zselgrath/ESP32_Dash_Firmware/NGDash_Image.png

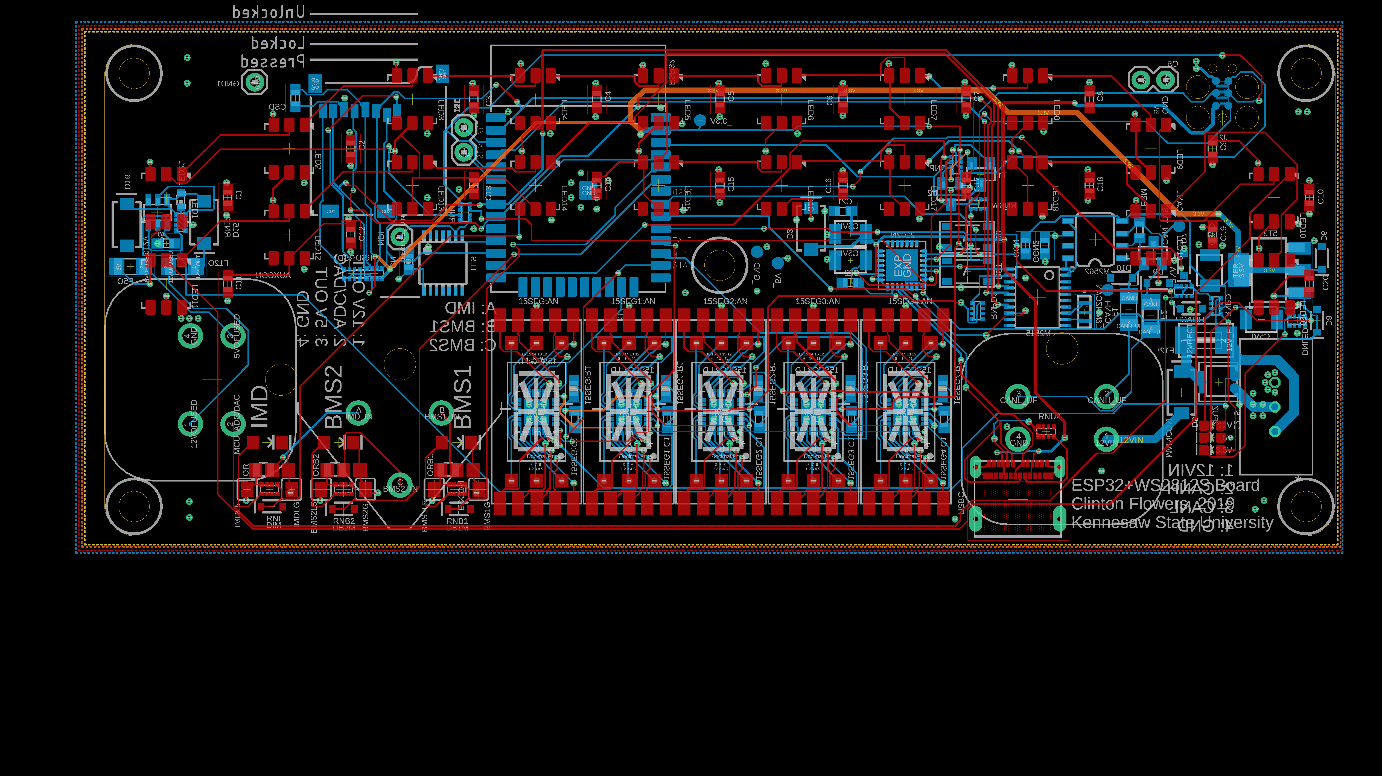
NGDash_Image.png
