zselgrath/ESP32_Dash_Firmware/NGDash.brd

## EAGLE design NGDash.brd (2019-10-20)

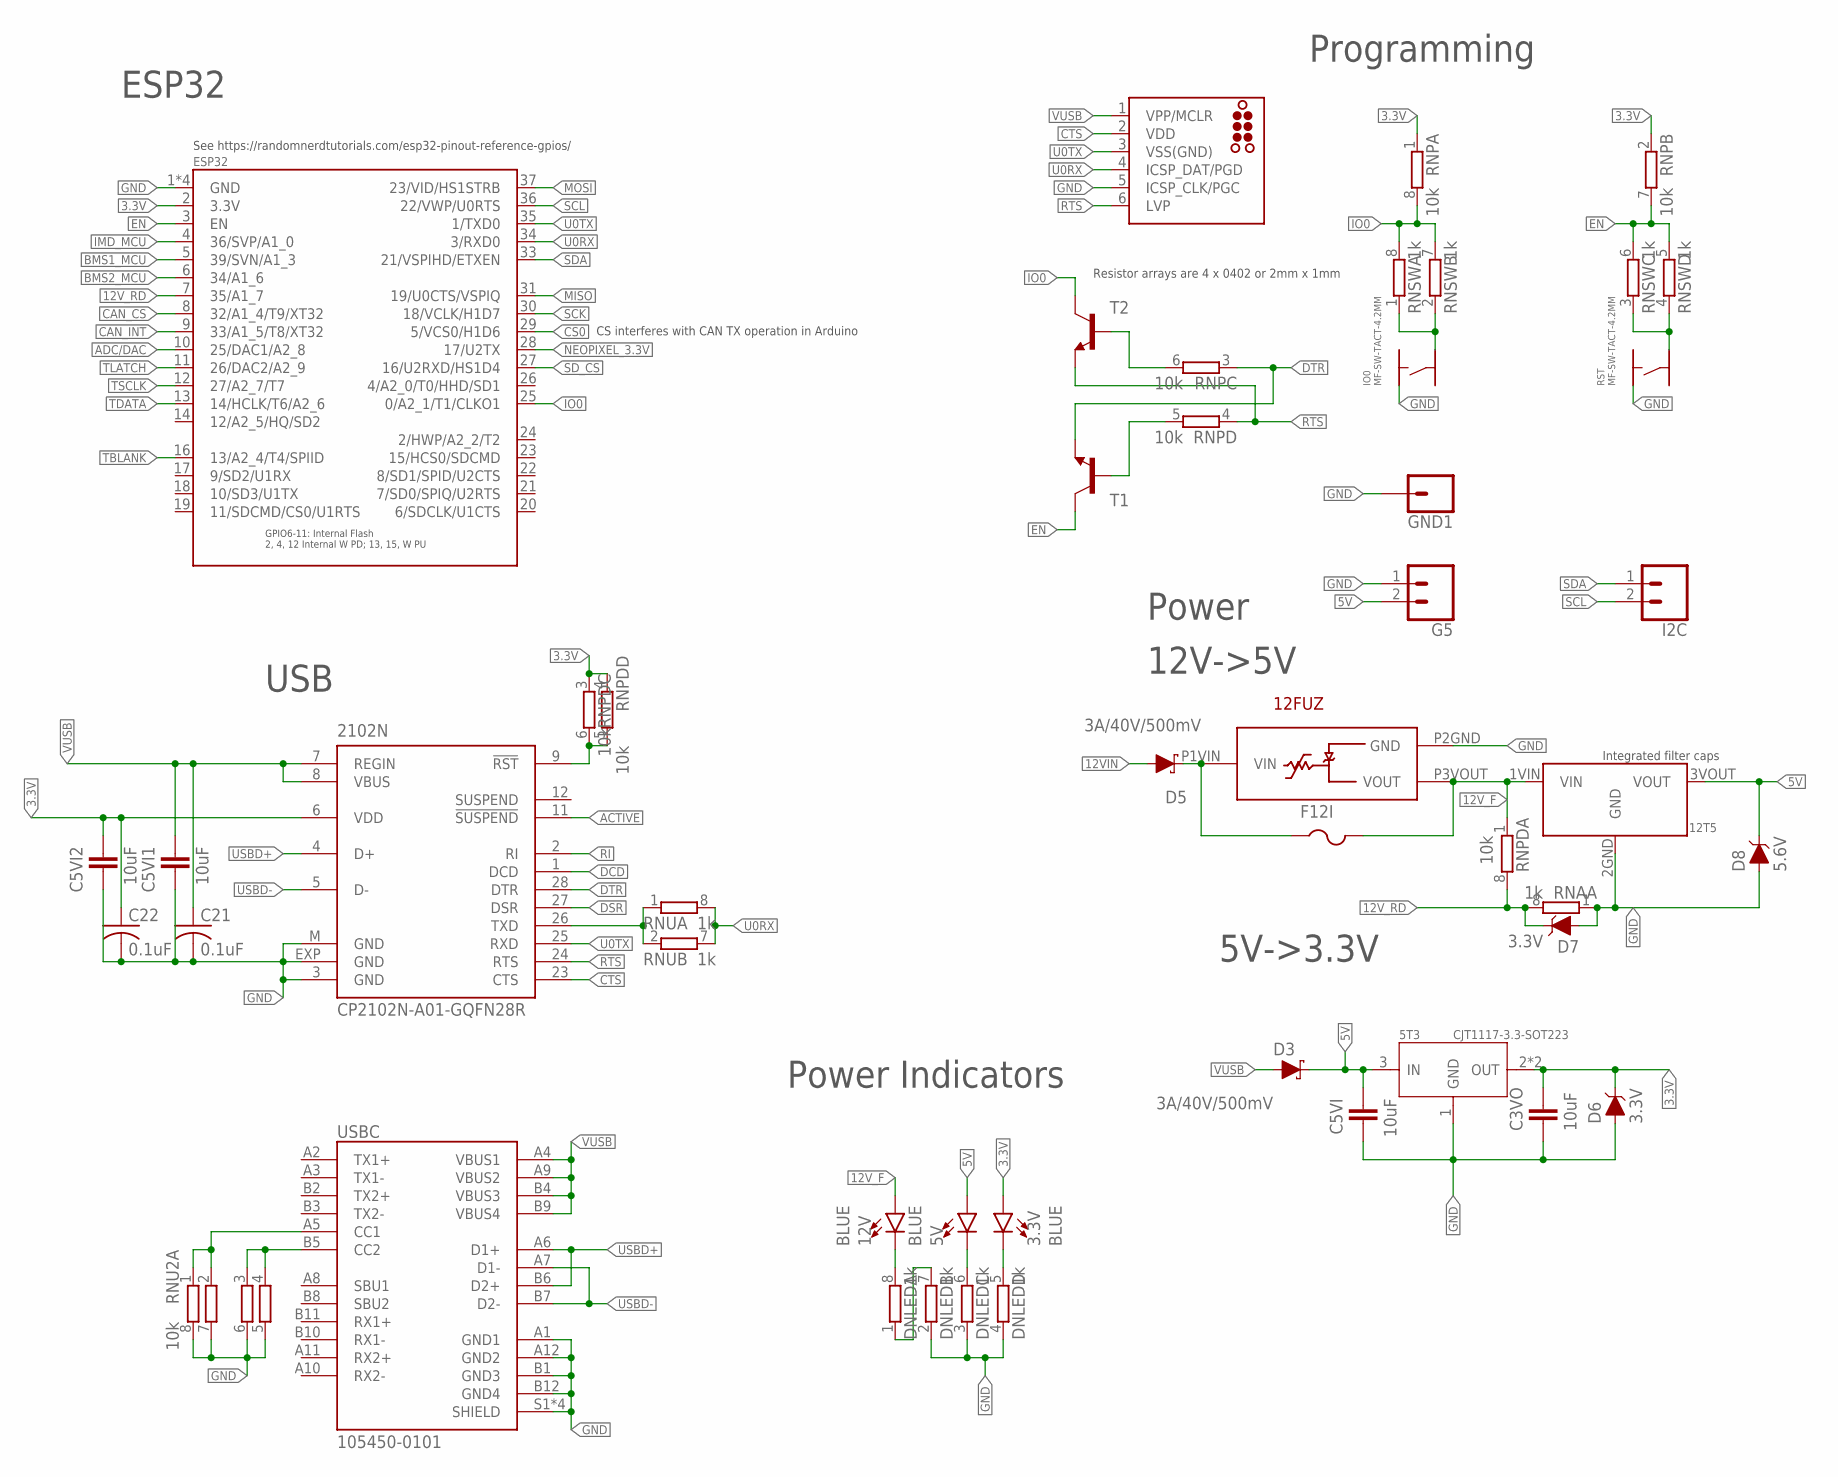
[picture p7: schematic NGDash.sch, sheet 1]

Parts:
3.3V, 5V, 12V: BLUE; LED-0603
5T3: CJT1117-3.3-SOT223; SOT-223
12FUZ: LITTELFUSE-POLYZEN-ZEN164V130A24LS
12T5: TRACO-TSR-2-2450
2102N: CP2102N-A01-GQFN28R; MLP28
C3VO, C5VI, C5VI1, C5VI2: 10uF; 1210
C21, C22: 0.1uF; C0603
D3, D5: 3A/40V/500mV; SMA-DIODE
D6, D7: 3.3V; SOD-323
D8: 5.6V; SOD-323
DNLED: 1k; 4X0402ARV341
ESP32: ESP32-WROOM-32; ESP32-WROOM32
F12I: PTCFUSE-1812; 1812
G5: CONN_02; 1X02
GND1: CONN_01; 1X01
I2C: CONN_02; 1X02
IO0: MF-SW-TACT-4.2MM; TACT4.2MM
J2: TC2030-MCP
RNA: 1k; 4X0402ARV341
RNP: 10k; 4X0402ARV341
RNPD: 10k; 4X0402ARV341
RNSW: 1k; 4X0402ARV341
RNU: 1k; 4X0402ARV341
RNU2: 10k; 4X0402ARV341
RST: MF-SW-TACT-4.2MM; TACT4.2MM
T1, T2: BC850-NPN-SOT23-BEC; SOT23-BEC
USBC: 105450-0101; MOLEX_105450-0101

Connections:
3.3V: 3.3V.A, 5T3.2 (OUT), 5T3.TER (OUT), 2102N.6 (VDD), C3VO.1, C5VI2.1, C22.1, D6.C, ESP32.2 (3.3V), RNP.1, RNP.2 (1), RNPD.3 (1), RNPD.4 (1); also elsewhere on the board
5V: 5T3.3 (IN), 5V.A, 12T5.3VOUT (VOUT), C5VI.1, D3.C, D8.C, G5.2; also elsewhere on the board
12VIN: D5.A; also elsewhere on the board
12VRECT: 12FUZ.P1VIN (VIN), D5.C, F12I.1
12V_F: 12FUZ.P3VOUT (VOUT), 12T5.1VIN (VIN), 12V.A, F12I.2, RNPD.1; also elsewhere on the board
12V_RD: D7.C, ESP32.7 (35/A1_7), RNA.8 (2), RNPD.8 (2)
ACTIVE: 2102N.11 (!SUSPEND)
ADC/DAC: ESP32.10 (25/DAC1/A2_8); also elsewhere on the board
BMS1_MCU: ESP32.5 (39/SVN/A1_3); also elsewhere on the board
BMS2_MCU: ESP32.6 (34/A1_6); also elsewhere on the board
CAN_CS: ESP32.8 (32/A1_4/T9/XT32); also elsewhere on the board
CAN_INT: ESP32.9 (33/A1_5/T8/XT32); also elsewhere on the board
CS0: ESP32.29 (5/VCS0/H1D6)
CTS: 2102N.23 (CTS), J2.2 (VDD)
DCD: 2102N.1 (DCD)
DSR: 2102N.27 (DSR)
DTR: 2102N.28 (DTR), RNP.3 (1), T1.E
EN: ESP32.3 (EN), RNP.7 (2), RNSW.5 (2), RNSW.6 (2), T1.C
GND: 5T3.1 (GND), 12FUZ.P2GND (GND), 12T5.2GND (GND), 2102N.3 (GND), 2102N.EXP (GND), 2102N.M (GND), C3VO.2, C5VI.2, C5VI1.2, C5VI2.2, C21.2, C22.2, D6.A, D7.A, D8.A, DNLED.2 (1), DNLED.3 (1), DNLED.4 (1), ESP32.1 (GND), ESP32.15 (GND), ESP32.38 (GND), ESP32.GND, G5.1, GND1.1, IO0.P$1, J2.5 (ICSP_CLK/PGC), RNA.1, RNU2.5 (2), RNU2.6 (2), RNU2.7 (2), RNU2.8 (2), RST.P$1, USBC.A1 (GND1), USBC.A12 (GND2), USBC.B1 (GND3), USBC.B12 (GND4), USBC.S1 (SHIELD), USBC.S2 (SHIELD), USBC.S3 (SHIELD), USBC.S4 (SHIELD); also elsewhere on the board
IMD_MCU: ESP32.4 (36/SVP/A1_0); also elsewhere on the board
IO0: ESP32.25 (0/A2_1/T1/CLKO1), RNP.8 (2), RNSW.7 (2), RNSW.8 (2), T2.C
MISO: ESP32.31 (19/U0CTS/VSPIQ); also elsewhere on the board
MOSI: ESP32.37 (23/VID/HS1STRB); also elsewhere on the board
unnamed: 5V.C, DNLED.6 (2)
unnamed: IO0.P$4, RNSW.1, RNSW.2 (1)
unnamed: RNP.5 (2), T1.B
unnamed: RNP.6 (2), T2.B
unnamed: RNU2.1, RNU2.2 (1), USBC.A5 (CC1)
unnamed: RNSW.3 (1), RNSW.4 (1), RST.P$4
unnamed: 3.3V.C, DNLED.5 (2)
unnamed: 2102N.9 (!RST), RNPD.5 (2), RNPD.6 (2)
unnamed: RNU2.3 (1), RNU2.4 (1), USBC.B5 (CC2)
unnamed: DNLED.1, DNLED.7 (2)
unnamed: 12V.C, DNLED.8 (2)
NEOPIXEL_3.3V: ESP32.28 (17/U2TX); also elsewhere on the board
RI: 2102N.2 (RI)
RTS: 2102N.24 (RTS), J2.6 (LVP), RNP.4 (1), T2.E
SCK: ESP32.30 (18/VCLK/H1D7); also elsewhere on the board
SCL: ESP32.36 (22/VWP/U0RTS), I2C.2
SDA: ESP32.33 (21/VSPIHD/ETXEN), I2C.1
SD_CS: ESP32.27 (16/U2RXD/HS1D4); also elsewhere on the board
TBLANK: ESP32.16 (13/A2_4/T4/SPIID); also elsewhere on the board
TDATA: ESP32.13 (14/HCLK/T6/A2_6); also elsewhere on the board
TLATCH: ESP32.11 (26/DAC2/A2_9); also elsewhere on the board
TSCLK: ESP32.12 (27/A2_7/T7); also elsewhere on the board
U0RX: ESP32.34 (3/RXD0), J2.4 (ICSP_DAT/PGD), RNU.7 (2), RNU.8 (2)
U0TX: 2102N.25 (RXD), ESP32.35 (1/TXD0), J2.3 (VSS(GND))
U0TXC: 2102N.26 (TXD), RNU.1, RNU.2 (1)
USBD+: 2102N.4 (D+), USBC.A6 (D1+), USBC.B6 (D2+)
USBD-: 2102N.5 (D-), USBC.A7 (D1-), USBC.B7 (D2-)
VUSB: 2102N.7 (REGIN), 2102N.8 (VBUS), C5VI1.1, C21.1, D3.A, J2.1 (VPP/MCLR), USBC.A4 (VBUS1), USBC.A9 (VBUS2), USBC.B4 (VBUS3), USBC.B9 (VBUS4)

Notes on the sheet:
Resistor arrays are 4 x 0402 or 2mm x 1mm
USB
Programming
Power
ESP32
5V->3.3V
CS interferes with CAN TX operation in Arduino
See https://randomnerdtutorials.com/esp32-pinout-reference-gpios/
12V->5V
Integrated filter caps
Power Indicators

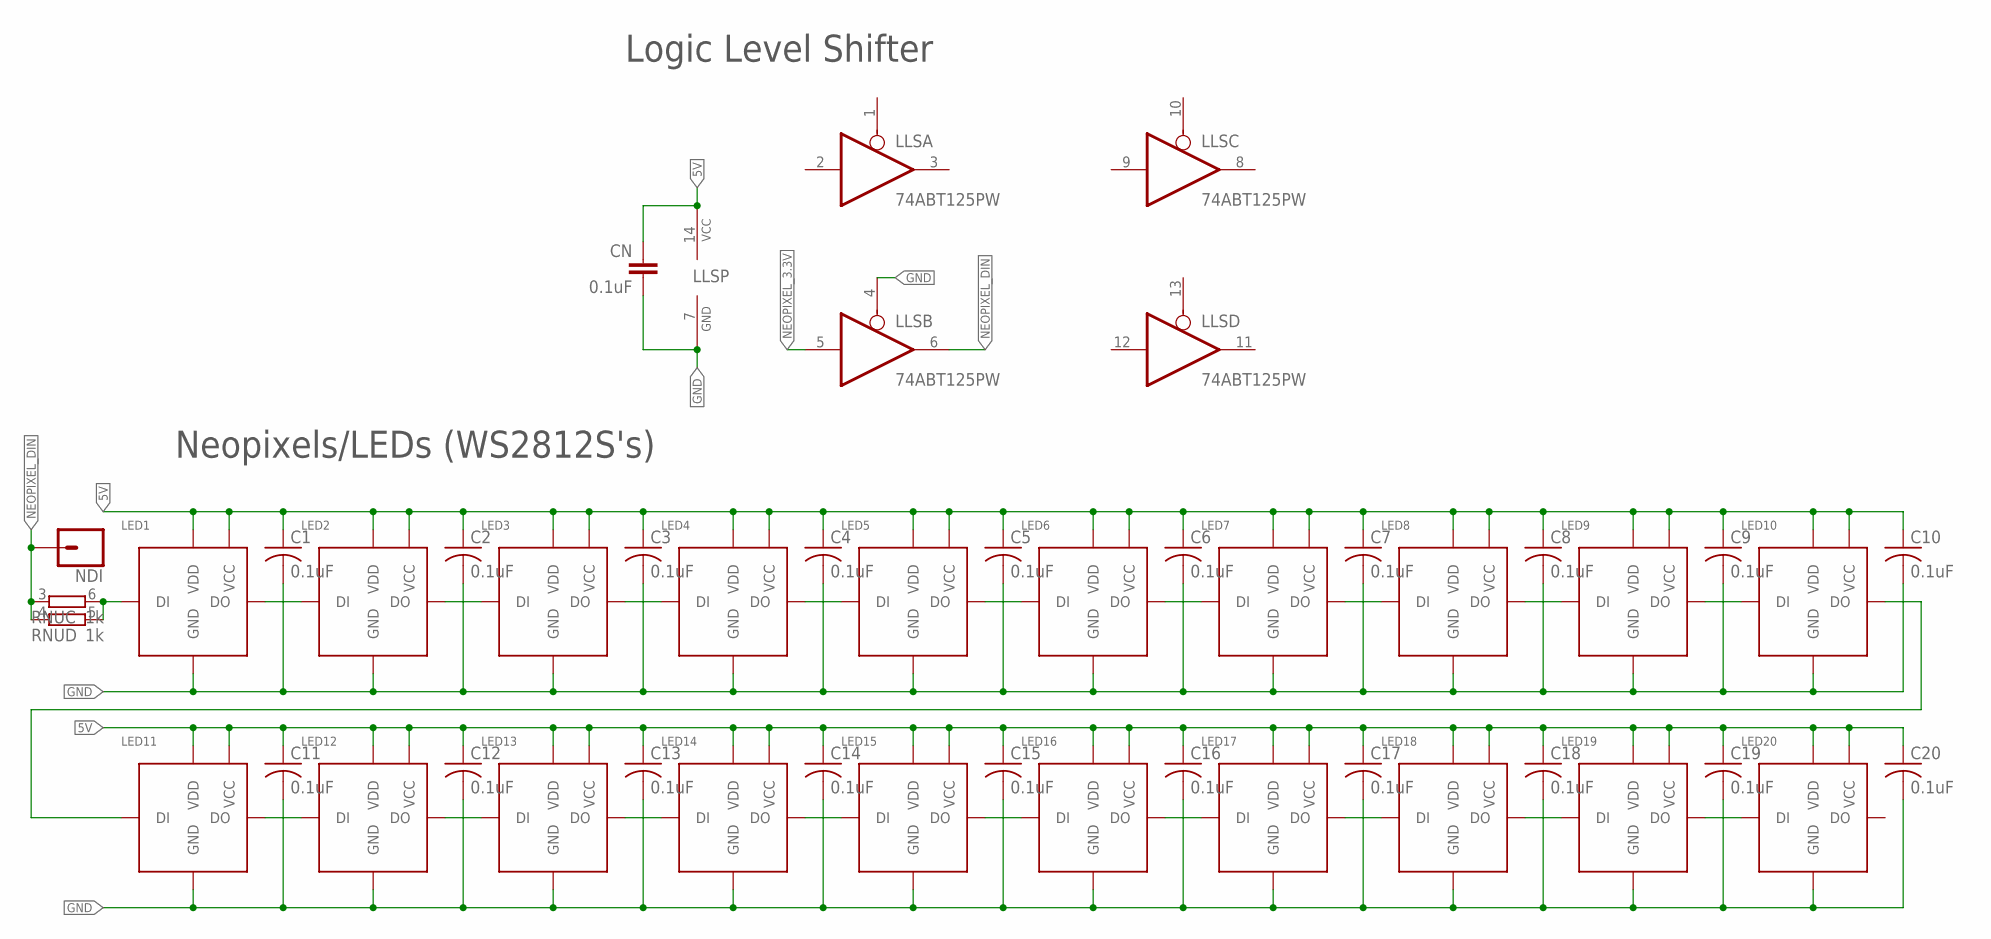
[picture p8: schematic NGDash.sch, sheet 2]

Parts:
C1, C2, C3, C4, C5, C6, C7, C8, C9, C10, C11, C12, C13, C14, C15, C16, C17, C18, C19, C20: 0.1uF; C0603
CN: 0.1uF; 0603-CAP
LED1, LED2, LED3, LED4, LED5, LED6, LED7, LED8, LED9, LED10, LED11, LED12, LED13, LED14, LED15, LED16, LED17, LED18, LED19, LED20: WS2812S; WS2812S5050
LLS: 74ABT125PW; TSSOP14
NDI: CONN_01; 1X01
RNU: 1k; 4X0402ARV341

Connections:
5V: C1.1, C2.1, C3.1, C4.1, C5.1, C6.1, C7.1, C8.1, C9.1, C10.1, C11.1, C12.1, C13.1, C14.1, C15.1, C16.1, C17.1, C18.1, C19.1, C20.1, CN.1, LED1.3_FS_VCC (VCC), LED1.5_FS_5V (VDD), LED2.3_FS_VCC (VCC), LED2.5_FS_5V (VDD), LED3.3_FS_VCC (VCC), LED3.5_FS_5V (VDD), LED4.3_FS_VCC (VCC), LED4.5_FS_5V (VDD), LED5.3_FS_VCC (VCC), LED5.5_FS_5V (VDD), LED6.3_FS_VCC (VCC), LED6.5_FS_5V (VDD), LED7.3_FS_VCC (VCC), LED7.5_FS_5V (VDD), LED8.3_FS_VCC (VCC), LED8.5_FS_5V (VDD), LED9.3_FS_VCC (VCC), LED9.5_FS_5V (VDD), LED10.3_FS_VCC (VCC), LED10.5_FS_5V (VDD), LED11.3_FS_VCC (VCC), LED11.5_FS_5V (VDD), LED12.3_FS_VCC (VCC), LED12.5_FS_5V (VDD), LED13.3_FS_VCC (VCC), LED13.5_FS_5V (VDD), LED14.3_FS_VCC (VCC), LED14.5_FS_5V (VDD), LED15.3_FS_VCC (VCC), LED15.5_FS_5V (VDD), LED16.3_FS_VCC (VCC), LED16.5_FS_5V (VDD), LED17.3_FS_VCC (VCC), LED17.5_FS_5V (VDD), LED18.3_FS_VCC (VCC), LED18.5_FS_5V (VDD), LED19.3_FS_VCC (VCC), LED19.5_FS_5V (VDD), LED20.3_FS_VCC (VCC), LED20.5_FS_5V (VDD), LLS.14 (VCC); also elsewhere on the board
GND: C1.2, C2.2, C3.2, C4.2, C5.2, C6.2, C7.2, C8.2, C9.2, C10.2, C11.2, C12.2, C13.2, C14.2, C15.2, C16.2, C17.2, C18.2, C19.2, C20.2, CN.2, LED1.6_FS_GND (GND), LED2.6_FS_GND (GND), LED3.6_FS_GND (GND), LED4.6_FS_GND (GND), LED5.6_FS_GND (GND), LED6.6_FS_GND (GND), LED7.6_FS_GND (GND), LED8.6_FS_GND (GND), LED9.6_FS_GND (GND), LED10.6_FS_GND (GND), LED11.6_FS_GND (GND), LED12.6_FS_GND (GND), LED13.6_FS_GND (GND), LED14.6_FS_GND (GND), LED15.6_FS_GND (GND), LED16.6_FS_GND (GND), LED17.6_FS_GND (GND), LED18.6_FS_GND (GND), LED19.6_FS_GND (GND), LED20.6_FS_GND (GND), LLS.4 (OE), LLS.7 (GND); also elsewhere on the board
unnamed: LED1.1_FS_DO (DO), LED2.2_FS_DI (DI)
unnamed: LED2.1_FS_DO (DO), LED3.2_FS_DI (DI)
unnamed: LED3.1_FS_DO (DO), LED4.2_FS_DI (DI)
unnamed: LED4.1_FS_DO (DO), LED5.2_FS_DI (DI)
unnamed: LED5.1_FS_DO (DO), LED6.2_FS_DI (DI)
unnamed: LED6.1_FS_DO (DO), LED7.2_FS_DI (DI)
unnamed: LED7.1_FS_DO (DO), LED8.2_FS_DI (DI)
unnamed: LED8.1_FS_DO (DO), LED9.2_FS_DI (DI)
unnamed: LED9.1_FS_DO (DO), LED10.2_FS_DI (DI)
unnamed: LED11.1_FS_DO (DO), LED12.2_FS_DI (DI)
unnamed: LED12.1_FS_DO (DO), LED13.2_FS_DI (DI)
unnamed: LED13.1_FS_DO (DO), LED14.2_FS_DI (DI)
unnamed: LED14.1_FS_DO (DO), LED15.2_FS_DI (DI)
unnamed: LED15.1_FS_DO (DO), LED16.2_FS_DI (DI)
unnamed: LED16.1_FS_DO (DO), LED17.2_FS_DI (DI)
unnamed: LED17.1_FS_DO (DO), LED18.2_FS_DI (DI)
unnamed: LED18.1_FS_DO (DO), LED19.2_FS_DI (DI)
unnamed: LED19.1_FS_DO (DO), LED20.2_FS_DI (DI)
unnamed: LED1.2_FS_DI (DI), RNU.5 (2), RNU.6 (2)
NDAT2: LED10.1_FS_DO (DO), LED11.2_FS_DI (DI)
NEOPIXEL_3.3V: LLS.5 (I); also elsewhere on the board
NEOPIXEL_DIN: LLS.6 (O), NDI.1, RNU.3 (1), RNU.4 (1)

Notes on the sheet:
Logic Level Shifter
Neopixels/LEDs (WS2812S's)

Schematic: NGDash.sch, sheet 3

Parts:
CSD: 0.1uF; C0603
J1: MICRO-SD_CARD_SOCKET; MICRO-SD-SOCKET
RSD, RSD1: 50k; 4X0402ARV341
_3.3V, _5V: TP
_CANH: TP
_CANL: TP
_GND: TP

Connections:
3.3V: CSD.1, J1.VCC, RSD.5 (2), RSD.6 (2), RSD.7 (2), RSD1.7 (2), RSD1.8 (2), _3.3V.P$1; also elsewhere on the board
5V: _5V.P$1; also elsewhere on the board
CANH: _CANH.P$1; also elsewhere on the board
CANL: _CANL.P$1; also elsewhere on the board
GND: CSD.2, J1.GND, J1.GND1 (SHIELD), J1.GND3 (SHIELD), RSD.8 (2), _GND.P$1; also elsewhere on the board
MISO: J1.DO, RSD.2 (1); also elsewhere on the board
MOSI: J1.DI, RSD.3 (1); also elsewhere on the board
unnamed: J1.RSV1 (RSV), RSD1.2 (1)
unnamed: J1.RSV2 (RSV), RSD1.1
SCK: J1.SCLK (SCK), RSD.1; also elsewhere on the board
SD_CS: J1.CS (!CS), RSD.4 (1); also elsewhere on the board

Notes on the sheet:
Alphanumerics
uSD Card

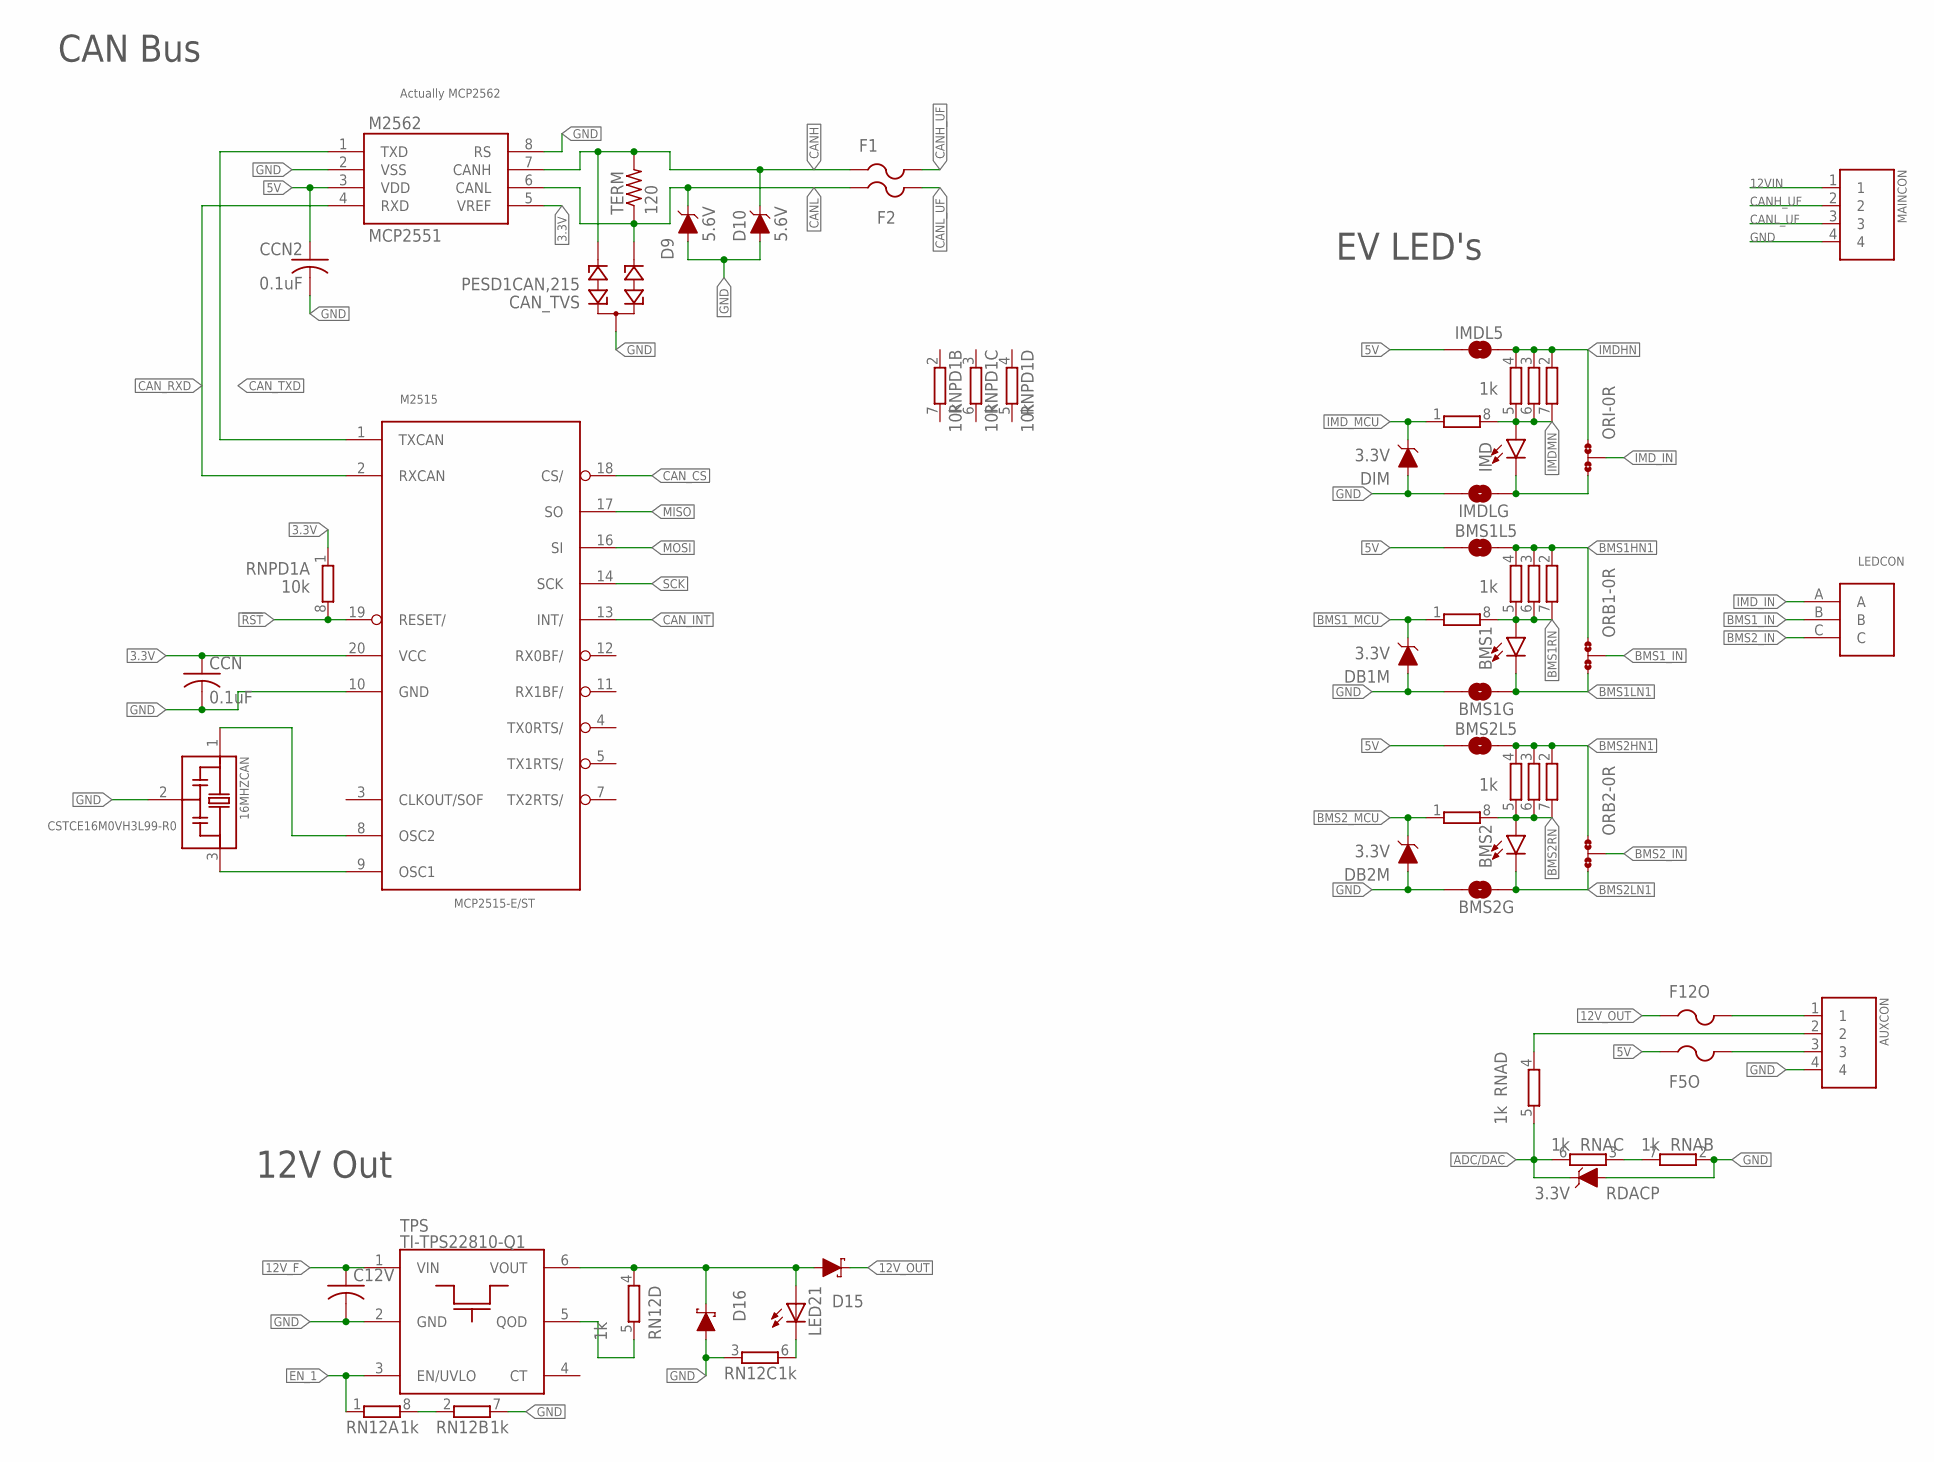
[picture p9: schematic NGDash.sch, sheet 4]

Parts:
16MHZCAN: CSTCE16M0VH3L99-R0; OSC_CSTCE16M0V53-R0
AUXCON: AMP-AT04-4P-BM02-DEUTSCH; AMP-AT04-4P-BM02
BMS1, BMS2: LED1206; LED-1206
BMS1G, BMS1L5, BMS2G, BMS2L5: JUMPER-SMT_2_NO_SILK; SMT-JUMPER_2_NO_SILK
C12V: C-USC0603; C0603
CAN_TVS: PESD1CAN,215; SOT23
CCN, CCN2: 0.1uF; C0603
D9, D10: 5.6V; SOD-323
D15, D16: 3A/40V/500mV; SMA-DIODE
DB1M, DB2M: 3.3V; SOD-323
DIM: 3.3V; SOD-323
F1, F2, F5O, F12O: PTCFUSE-1206; R1206
IMD: LED1206; LED-1206
IMDL5: JUMPER-SMT_2_NO_SILK; SMT-JUMPER_2_NO_SILK
IMDLG: JUMPER-SMT_2_NO_SILK; SMT-JUMPER_2_NO_SILK
LED21: LEDCHIP-LED0603; CHIP-LED0603
LEDCON: AMP-AT04-3P-BM02-DEUTSCH; AMP-AT04-3P-BM02
M2515: MCP2515-E/ST; TSSOP20
M2562: MCP2551; SO08
MAINCON: AMP-AT04-4P-BM02-DEUTSCH; AMP-AT04-4P-BM02
ORB1, ORB2: 0R-JUMPA; A0R-JMP
ORI: 0R-JUMPA; A0R-JMP
RDACP: 3.3V; SOD-323
RN12: 1k; 4X0402ARV341
RNA: 1k; 4X0402ARV341
RNB1, RNB2: 1k; 4X0402ARV341
RNI: 1k; 4X0402ARV341
RNPD1: 10k; 4X0402ARV341
TERM: 120; R0603
TPS: TI-TPS22810-Q1; SOT23-6

Connections:
3.3V: CCN.1, M2515.20 (VCC), M2562.5 (VREF), RNPD1.1; also elsewhere on the board
5V: BMS1L5.1, BMS2L5.1, CCN2.1, F5O.1, IMDL5.1, M2562.3 (VDD); also elsewhere on the board
5VOFUSED: AUXCON.3, F5O.2
12VIN: MAINCON.1; also elsewhere on the board
12VOFUSED: AUXCON.1, F12O.2
12V_F: C12V.1, TPS.1 (VIN); also elsewhere on the board
12V_OUT: D15.C, F12O.1
12V_SW: D15.A, D16.C, LED21.A, RN12.4 (1), TPS.6 (VOUT)
!RST: M2515.19 (RESET/), RNPD1.8 (2)
ADC/DAC: RDACP.C, RNA.5 (2), RNA.6 (2); also elsewhere on the board
BMS1HN1: BMS1L5.2, ORB1.1, RNB1.2 (1), RNB1.3 (1), RNB1.4 (1)
BMS1LN1: BMS1.C, BMS1G.2, ORB1.3
BMS1RN: BMS1.A, RNB1.5 (2), RNB1.6 (2), RNB1.7 (2), RNB1.8 (2)
BMS1_IN: LEDCON.B, ORB1.2
BMS1_MCU: DB1M.C, RNB1.1; also elsewhere on the board
BMS2HN1: BMS2L5.2, ORB2.1, RNB2.2 (1), RNB2.3 (1), RNB2.4 (1)
BMS2LN1: BMS2.C, BMS2G.2, ORB2.3
BMS2RN: BMS2.A, RNB2.5 (2), RNB2.6 (2), RNB2.7 (2), RNB2.8 (2)
BMS2_IN: LEDCON.C, ORB2.2
BMS2_MCU: DB2M.C, RNB2.1; also elsewhere on the board
CANH: CAN_TVS.2, D10.C, F1.1, M2562.7 (CANH), TERM.2; also elsewhere on the board
CANH_UF: F1.2, MAINCON.2
CANL: CAN_TVS.1, D9.C, F2.1, M2562.6 (CANL), TERM.1; also elsewhere on the board
CANL_UF: F2.2, MAINCON.3
CAN_CS: M2515.18 (CS/); also elsewhere on the board
CAN_INT: M2515.13 (INT/); also elsewhere on the board
CAN_RXD: M2515.2 (RXCAN), M2562.4 (RXD)
CAN_TXD: M2515.1 (TXCAN), M2562.1 (TXD)
EN_1: RN12.1, TPS.3 (EN/UVLO)
GND: 16MHZCAN.2, AUXCON.4, BMS1G.1, BMS2G.1, C12V.2, CAN_TVS.3, CCN.2, CCN2.2, D9.A, D10.A, D16.A, DB1M.A, DB2M.A, DIM.A, IMDLG.1, M2515.10 (GND), M2562.2 (VSS), M2562.8 (RS), MAINCON.4, RDACP.A, RN12.3 (1), RN12.7 (2), RNA.2 (1), TPS.2 (GND); also elsewhere on the board
IMDHN: IMDL5.2, ORI.1, RNI.2 (1), RNI.3 (1), RNI.4 (1)
IMDLN: IMD.C, IMDLG.2, ORI.3
IMDMN: IMD.A, RNI.5 (2), RNI.6 (2), RNI.7 (2), RNI.8 (2)
IMD_IN: LEDCON.A, ORI.2
IMD_MCU: DIM.C, RNI.1; also elsewhere on the board
MCU_ADC/DAC: AUXCON.2, RNA.4 (1)
MISO: M2515.17 (SO); also elsewhere on the board
MOSI: M2515.16 (SI); also elsewhere on the board
unnamed: 16MHZCAN.1, M2515.8 (OSC2)
unnamed: 16MHZCAN.3, M2515.9 (OSC1)
unnamed: LED21.C, RN12.6 (2)
unnamed: RNA.3 (1), RNA.7 (2)
unnamed: RN12.2 (1), RN12.8 (2)
QOD1: RN12.5 (2), TPS.5 (QOD)
SCK: M2515.14 (SCK); also elsewhere on the board

Notes on the sheet:
Actually MCP2562
CAN Bus
EV LED's
12V Out

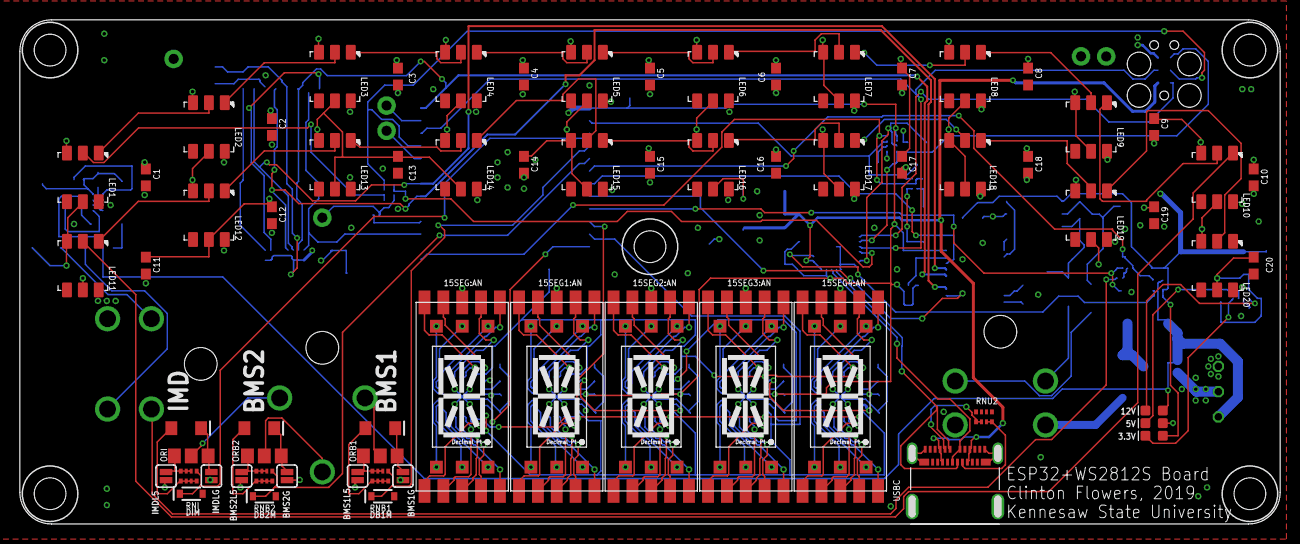
[picture p10: board NGDash.brd from above]

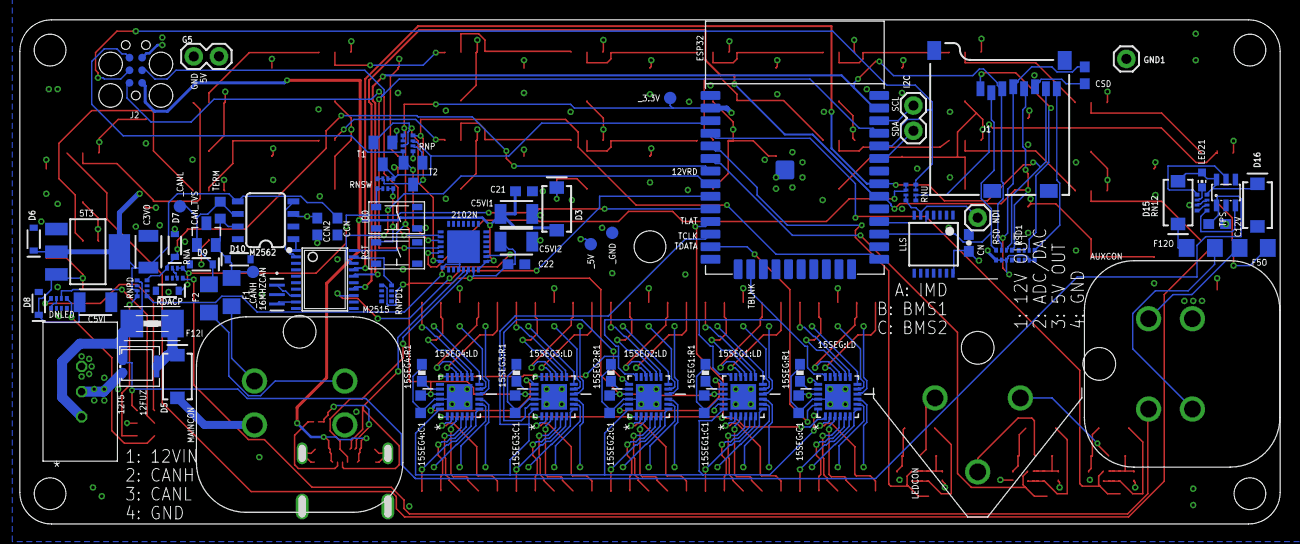
[picture p11: board NGDash.brd from below]

Board: 4 copper layers, 127.0 x 50.8 mm, 150 parts (82 on the bottom side), 184 nets.

Other parts of the board:
15SEG1:AN, 15SEG2:AN, 15SEG3:AN, 15SEG4:AN, 15SEG:AN: ACPSA04-41SYKWA
15SEG1:C1, 15SEG2:C1, 15SEG3:C1, 15SEG4:C1, 15SEG:C1: 0.1uF; C0603K
15SEG1:LD, 15SEG2:LD, 15SEG3:LD, 15SEG4:LD, 15SEG:LD: TLC59281RGER; QFN50P400X400X100-25N
15SEG1:R1, 15SEG2:R1, 15SEG3:R1, 15SEG4:R1, 15SEG:R1: 2.5k; 0603-RES

Their connections:
3.3V: 15SEG1:C1.1, 15SEG1:LD.21, 15SEG2:C1.1, 15SEG2:LD.21, 15SEG3:C1.1, 15SEG3:LD.21, 15SEG4:C1.1, 15SEG4:LD.21, 15SEG:C1.1, 15SEG:LD.21; also elsewhere on the board
5V: 15SEG1:AN.P$14, 15SEG2:AN.P$14, 15SEG3:AN.P$14, 15SEG4:AN.P$14, 15SEG:AN.P$14; also elsewhere on the board
15SEG1:N$1: 15SEG1:LD.20, 15SEG1:R1.1
15SEG1:N$2: 15SEG1:AN.P$1, 15SEG1:LD.2
15SEG1:N$3: 15SEG1:AN.P$2, 15SEG1:LD.3
15SEG1:N$4: 15SEG1:AN.P$3, 15SEG1:LD.4
15SEG1:N$5: 15SEG1:AN.P$4, 15SEG1:LD.5
15SEG1:N$6: 15SEG1:AN.P$5, 15SEG1:LD.6
15SEG1:N$7: 15SEG1:AN.P$6, 15SEG1:LD.7
15SEG1:N$8: 15SEG1:AN.P$7, 15SEG1:LD.8
15SEG1:N$9: 15SEG1:AN.P$8, 15SEG1:LD.9
15SEG1:N$10: 15SEG1:AN.P$9, 15SEG1:LD.10
15SEG1:N$11: 15SEG1:AN.P$10, 15SEG1:LD.11
15SEG1:N$12: 15SEG1:AN.P$11, 15SEG1:LD.12
15SEG1:N$13: 15SEG1:AN.P$12, 15SEG1:LD.13
15SEG1:N$14: 15SEG1:AN.P$13, 15SEG1:LD.14
15SEG1:N$15: 15SEG1:AN.P$15, 15SEG1:LD.15
15SEG1:N$16: 15SEG1:AN.P$16, 15SEG1:LD.16
15SEG2:N$1: 15SEG2:LD.20, 15SEG2:R1.1
15SEG2:N$2: 15SEG2:AN.P$1, 15SEG2:LD.2
15SEG2:N$3: 15SEG2:AN.P$2, 15SEG2:LD.3
15SEG2:N$4: 15SEG2:AN.P$3, 15SEG2:LD.4
15SEG2:N$5: 15SEG2:AN.P$4, 15SEG2:LD.5
15SEG2:N$6: 15SEG2:AN.P$5, 15SEG2:LD.6
15SEG2:N$7: 15SEG2:AN.P$6, 15SEG2:LD.7
15SEG2:N$8: 15SEG2:AN.P$7, 15SEG2:LD.8
15SEG2:N$9: 15SEG2:AN.P$8, 15SEG2:LD.9
15SEG2:N$10: 15SEG2:AN.P$9, 15SEG2:LD.10
15SEG2:N$11: 15SEG2:AN.P$10, 15SEG2:LD.11
15SEG2:N$12: 15SEG2:AN.P$11, 15SEG2:LD.12
15SEG2:N$13: 15SEG2:AN.P$12, 15SEG2:LD.13
15SEG2:N$14: 15SEG2:AN.P$13, 15SEG2:LD.14
15SEG2:N$15: 15SEG2:AN.P$15, 15SEG2:LD.15
15SEG2:N$16: 15SEG2:AN.P$16, 15SEG2:LD.16
15SEG3:N$1: 15SEG3:LD.20, 15SEG3:R1.1
15SEG3:N$2: 15SEG3:AN.P$1, 15SEG3:LD.2
15SEG3:N$3: 15SEG3:AN.P$2, 15SEG3:LD.3
15SEG3:N$4: 15SEG3:AN.P$3, 15SEG3:LD.4
15SEG3:N$5: 15SEG3:AN.P$4, 15SEG3:LD.5
15SEG3:N$6: 15SEG3:AN.P$5, 15SEG3:LD.6
15SEG3:N$7: 15SEG3:AN.P$6, 15SEG3:LD.7
15SEG3:N$8: 15SEG3:AN.P$7, 15SEG3:LD.8
15SEG3:N$9: 15SEG3:AN.P$8, 15SEG3:LD.9
15SEG3:N$10: 15SEG3:AN.P$9, 15SEG3:LD.10
15SEG3:N$11: 15SEG3:AN.P$10, 15SEG3:LD.11
15SEG3:N$12: 15SEG3:AN.P$11, 15SEG3:LD.12
15SEG3:N$13: 15SEG3:AN.P$12, 15SEG3:LD.13
15SEG3:N$14: 15SEG3:AN.P$13, 15SEG3:LD.14
15SEG3:N$15: 15SEG3:AN.P$15, 15SEG3:LD.15
15SEG3:N$16: 15SEG3:AN.P$16, 15SEG3:LD.16
15SEG4:N$1: 15SEG4:LD.20, 15SEG4:R1.1
15SEG4:N$2: 15SEG4:AN.P$1, 15SEG4:LD.2
15SEG4:N$3: 15SEG4:AN.P$2, 15SEG4:LD.3
15SEG4:N$4: 15SEG4:AN.P$3, 15SEG4:LD.4
15SEG4:N$5: 15SEG4:AN.P$4, 15SEG4:LD.5
15SEG4:N$6: 15SEG4:AN.P$5, 15SEG4:LD.6
15SEG4:N$7: 15SEG4:AN.P$6, 15SEG4:LD.7
15SEG4:N$8: 15SEG4:AN.P$7, 15SEG4:LD.8
15SEG4:N$9: 15SEG4:AN.P$8, 15SEG4:LD.9
15SEG4:N$10: 15SEG4:AN.P$9, 15SEG4:LD.10
15SEG4:N$11: 15SEG4:AN.P$10, 15SEG4:LD.11
15SEG4:N$12: 15SEG4:AN.P$11, 15SEG4:LD.12
15SEG4:N$13: 15SEG4:AN.P$12, 15SEG4:LD.13
15SEG4:N$14: 15SEG4:AN.P$13, 15SEG4:LD.14
15SEG4:N$15: 15SEG4:AN.P$15, 15SEG4:LD.15
15SEG4:N$16: 15SEG4:AN.P$16, 15SEG4:LD.16
15SEG:N$1: 15SEG:LD.20, 15SEG:R1.1
15SEG:N$2: 15SEG:AN.P$1, 15SEG:LD.2
15SEG:N$3: 15SEG:AN.P$2, 15SEG:LD.3
15SEG:N$4: 15SEG:AN.P$3, 15SEG:LD.4
15SEG:N$5: 15SEG:AN.P$4, 15SEG:LD.5
15SEG:N$6: 15SEG:AN.P$5, 15SEG:LD.6
15SEG:N$7: 15SEG:AN.P$6, 15SEG:LD.7
15SEG:N$8: 15SEG:AN.P$7, 15SEG:LD.8
15SEG:N$9: 15SEG:AN.P$8, 15SEG:LD.9
15SEG:N$10: 15SEG:AN.P$9, 15SEG:LD.10
15SEG:N$11: 15SEG:AN.P$10, 15SEG:LD.11
15SEG:N$12: 15SEG:AN.P$11, 15SEG:LD.12
15SEG:N$13: 15SEG:AN.P$12, 15SEG:LD.13
15SEG:N$14: 15SEG:AN.P$13, 15SEG:LD.14
15SEG:N$15: 15SEG:AN.P$15, 15SEG:LD.15
15SEG:N$16: 15SEG:AN.P$16, 15SEG:LD.16
GND: 15SEG1:C1.2, 15SEG1:LD.22, 15SEG1:LD.25, 15SEG1:R1.2, 15SEG2:C1.2, 15SEG2:LD.22, 15SEG2:LD.25, 15SEG2:R1.2, 15SEG3:C1.2, 15SEG3:LD.22, 15SEG3:LD.25, 15SEG3:R1.2, 15SEG4:C1.2, 15SEG4:LD.22, 15SEG4:LD.25, 15SEG4:R1.2, 15SEG:C1.2, 15SEG:LD.22, 15SEG:LD.25, 15SEG:R1.2; also elsewhere on the board
unnamed: 15SEG1:LD.23, 15SEG:LD.19
unnamed: 15SEG1:LD.19, 15SEG2:LD.23
unnamed: 15SEG2:LD.19, 15SEG3:LD.23
unnamed: 15SEG3:LD.19, 15SEG4:LD.23
TBLANK: 15SEG1:LD.18, 15SEG2:LD.18, 15SEG3:LD.18, 15SEG4:LD.18, 15SEG:LD.18; also elsewhere on the board
TDATA: 15SEG:LD.23; also elsewhere on the board
TLATCH: 15SEG1:LD.1, 15SEG2:LD.1, 15SEG3:LD.1, 15SEG4:LD.1, 15SEG:LD.1; also elsewhere on the board
TSCLK: 15SEG1:LD.24, 15SEG2:LD.24, 15SEG3:LD.24, 15SEG4:LD.24, 15SEG:LD.24; also elsewhere on the board
